tiandahuang/imu-harvester/imu-harvester-back.png

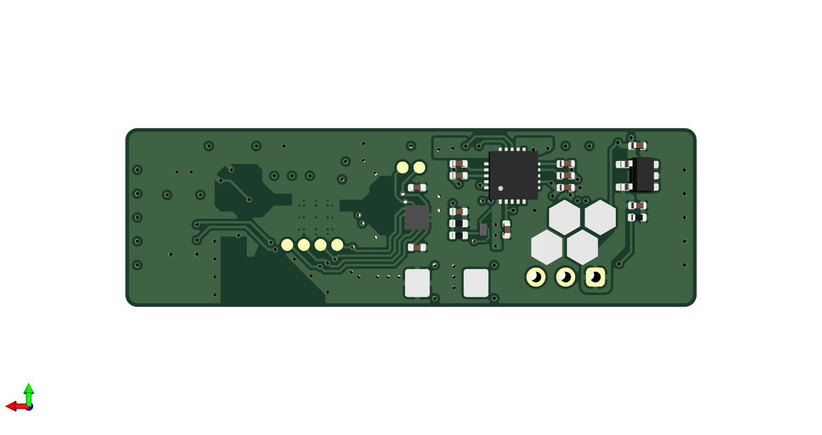
imu-harvester-back.png
