tiandahuang/imu-harvester/imu-harvester-front.png

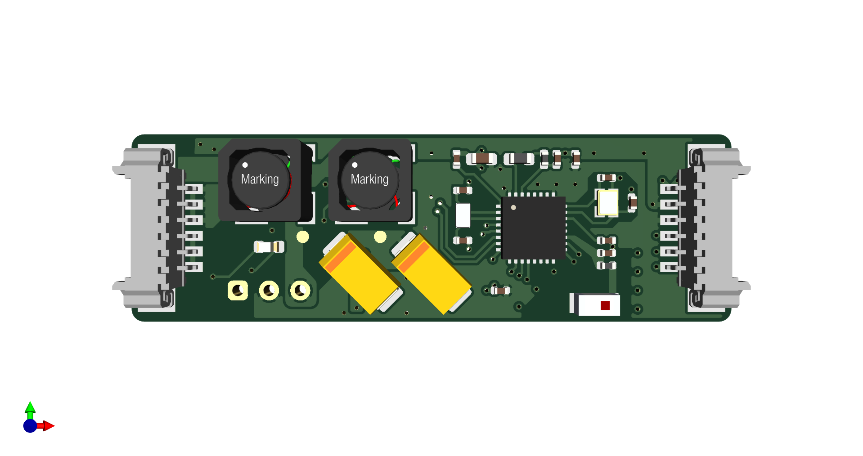
imu-harvester-front.png
