tiandahuang/imu-harvester/imu-harvester.kicad_pcb

## KiCad design imu-harvester.kicad_pcb (2024-02-24)

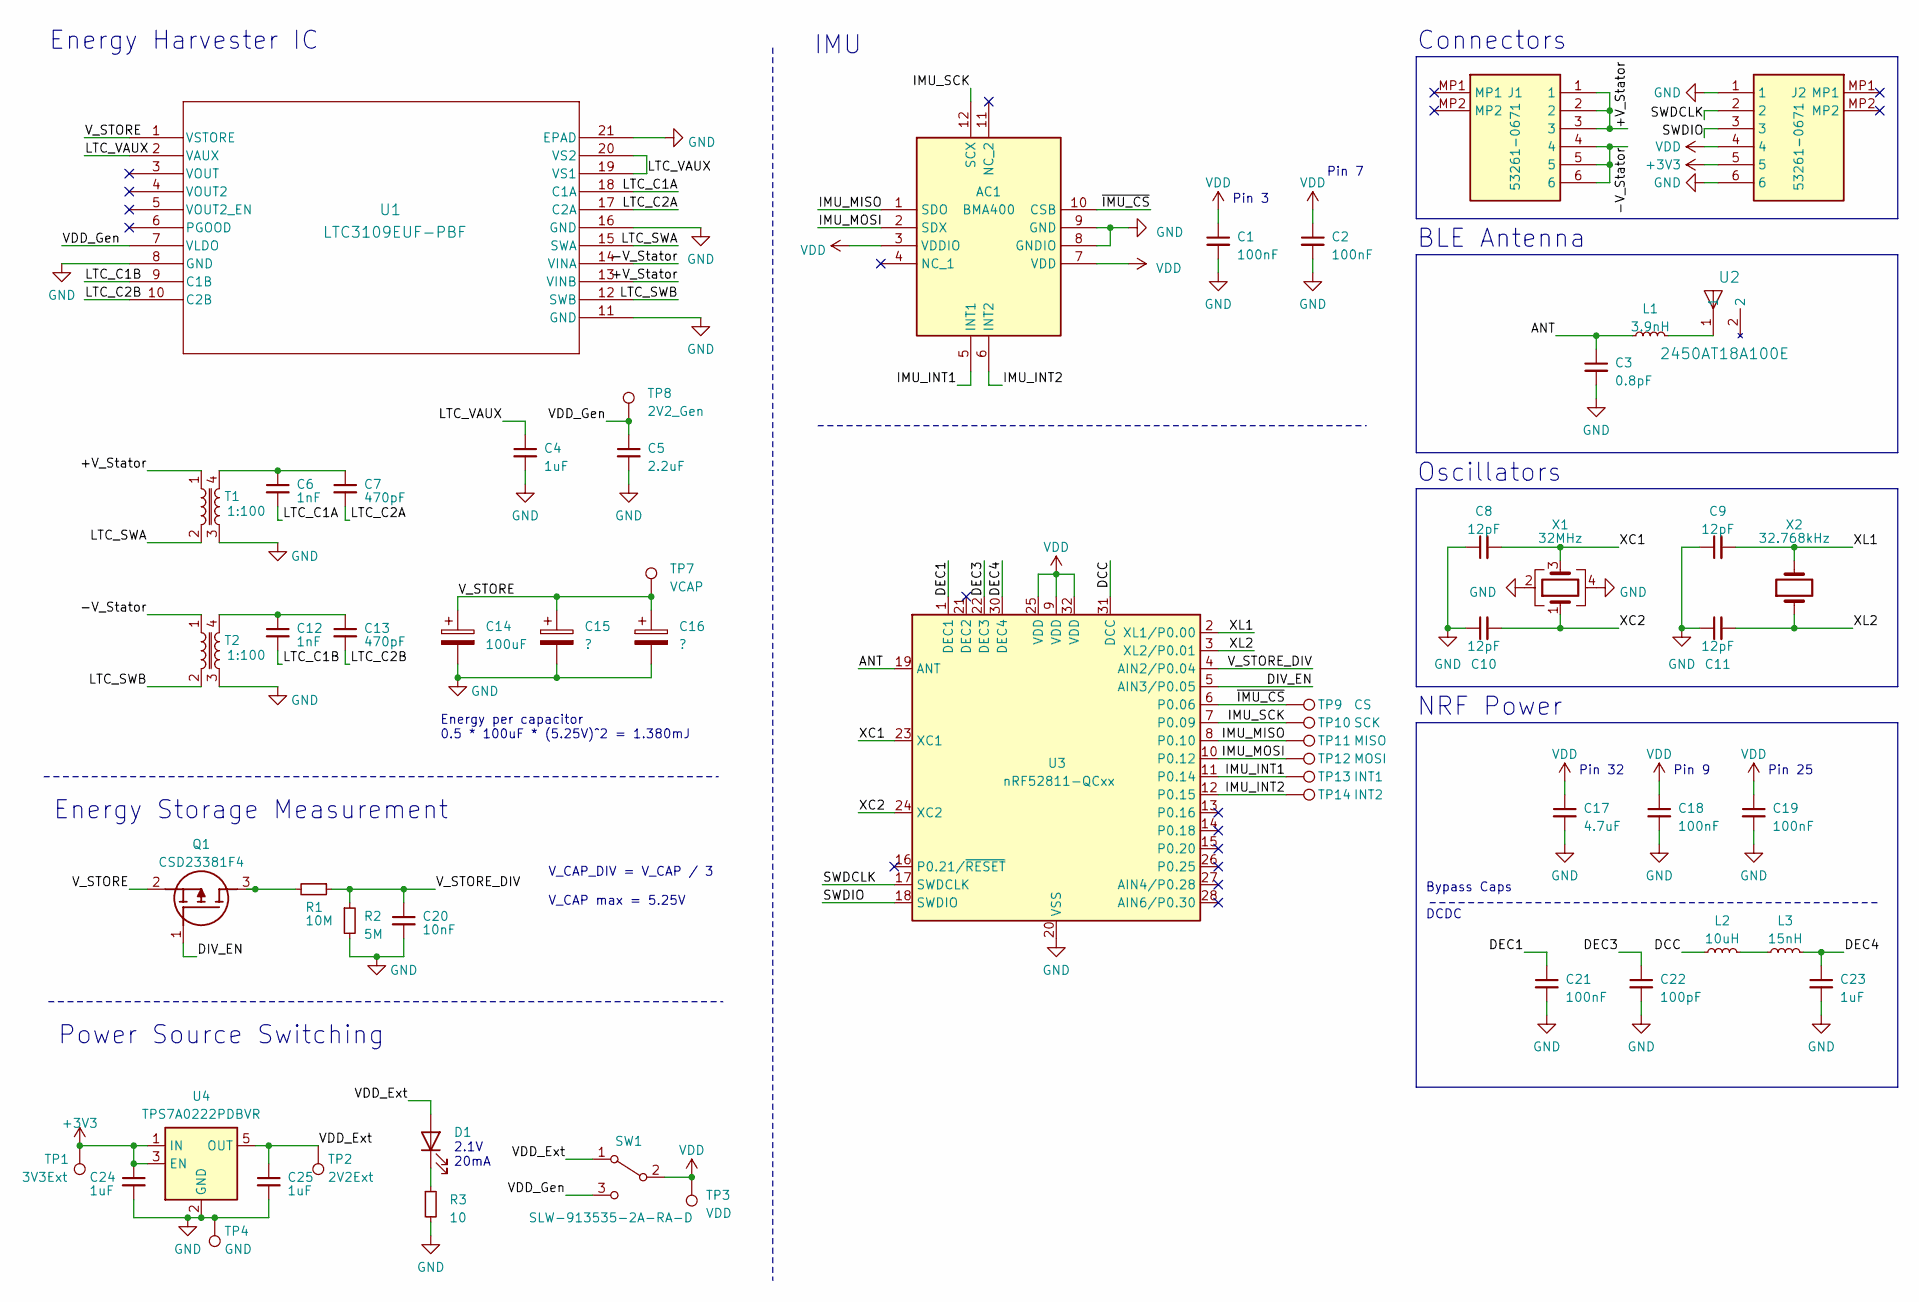
[picture p3: schematic imu-harvester.kicad_sch]

Parts:
AC1: BMA400; BOSCH_LGA-12; Mouser Part Number 262-BMA400
C1, C2, C18, C19, C21: 100nF; C_0402_1005Metric; Manufacturer_Part_Number KGM05AR71C104KN
C3: 0.8pF; C_0402_1005Metric; Manufacturer_Part_Number GRM1555C1ER80BA01D
C4, C23, C24, C25: 1uF; C_0402_1005Metric; Manufacturer_Part_Number CM05X7R105K06AH-HE
C5: 2.2uF; C_0402_1005Metric; Manufacturer_Part_Number GRM155Z71A225KE01D
C6, C12: 1nF; C_0402_1005Metric; Manufacturer_Part_Number C0402C102KCRACAUTO
C7, C13: 470pF; C_0402_1005Metric; Manufacturer_Part_Number KGM05ACG1H471JH
C8, C9, C10, C11: 12pF; C_0402_1005Metric; Manufacturer_Part_Number KGM05ACG1H120JN
C14: 100uF; CP_EIA-6032-28_Kemet-C; Manufacturer_Part_Number TL3C107K010C0200
C15, C16: ?; CP_EIA-6032-28_Kemet-C
C17: 4.7uF; C_0603_1608Metric; Manufacturer_Part_Number GRM188Z71C475KE21D
C20: 10nF; C_0402_1005Metric; Manufacturer_Part_Number C0402C103K1RACAUTO
C22: 100pF; C_0402_1005Metric; Manufacturer_Part_Number KGM05ACG1H101JN
D1: LO Q976.01-P2R2-25-1; LED_0603_1608Metric; Manufacturer_Part_Number LO Q976.01-P2R2-25-1
J1, J2: 53261-0671; 532610671; Mouser Part Number 538-53261-0671
L1: 3.9nH; L_0402_1005Metric; Manufacturer_Part_Number LQG15WZ3N9B02D
L2: 10uH; L_0603_1608Metric; Manufacturer_Part_Number KLZ1608MHR100WTD25
L3: 15nH; L_0402_1005Metric; Manufacturer_Part_Number LQG15WZ15NG02D
Q1: CSD23381F4; Mouser Part Number 595-CSD23381F4
R1: 10M; R_0402_1005Metric; Manufacturer_Part_Number RCC040210M0FKED
R2: 5M; R_0402_1005Metric; Manufacturer_Part_Number CRCW04024M99FKED
R3: 10; R_0402_1005Metric; Manufacturer_Part_Number RCC040210R0FKED
SW1: SLW-913535-2A-RA-D; Manufacturer_Part_Number SLW-913535-2A-RA-D
T1, T2: 1:100; 74488540070; Manufacturer_Part_Number 74488540070
TP1: 3V3Ext; Testpoint_Hex_D3.0
TP2: 2V2Ext; Testpoint_Hex_D3.0
TP3: VDD; Testpoint_Hex_D3.0
TP4: GND; Testpoint_Hex_D3.0
TP7: VCAP; TestPoint_Pad_D1.0mm
TP8: 2V2_Gen; TestPoint_Pad_D1.0mm
TP9: CS; TestPoint_Pad_D1.0mm
TP10: SCK; TestPoint_Pad_D1.0mm
TP11: MISO; TestPoint_Pad_D1.0mm
TP12: MOSI; TestPoint_Pad_D1.0mm
TP13: INT1; TestPoint_Pad_D1.0mm
TP14: INT2; TestPoint_Pad_D1.0mm
U1: LTC3109EUF-PBF; QFN-20_UF_LIT; Manufacturer_Part_Number LTC3109EUF#PBF
U2: 2450AT18A100E; 2450AT18A100E_JOT; Manufacturer_Part_Number 2450AT18A100E
U3: nRF52811-QCxx; QFN-32-1EP_5x5mm_P0.5mm_EP3.6x3.6mm_ThermalVias; Manufacturer_Part_Number nRF52811-QCAA-R
U4: TPS7A0222PDBVR; SOT-23-5; Manufacturer_Part_Number TPS7A0222PDBVR
X1: 32MHz; Crystal_SMD_2016-4Pin_2.0x1.6mm; Manufacturer_Part_Number ECS-320-8-37B2-JTY-TR
X2: 32.768kHz; Crystal_SMD_2012-2Pin_2.0x1.2mm; Manufacturer_Part_Number ECS-.327-9-12R-TR

Connections:
+3V3: C24.1, J2.5, TP1.1, U4.1 (IN), U4.3 (EN)
/+V_Stator: J1.1, J1.2, J1.3, T1.1, U1.13 (VINB)
/-V_Stator: J1.4, J1.5, J1.6, T2.1, U1.14 (VINA)
/ANT: C3.1, L1.1, U3.19 (ANT)
/DCC: L2.1, U3.31 (DCC)
/DEC1: C21.1, U3.1 (DEC1)
/DEC3: C22.1, U3.22 (DEC3)
/DEC4: C23.1, L3.2, U3.30 (DEC4)
/DIV_EN: Q1.1 (G), U3.5 (AIN3/P0.05)
/IMU_INT1: AC1.5 (INT1), TP13.1, U3.11 (P0.14)
/IMU_INT2: AC1.6 (INT2), TP14.1, U3.12 (P0.15)
/IMU_MISO: AC1.1 (SDO), TP11.1, U3.8 (P0.10)
/IMU_MOSI: AC1.2 (SDX), TP12.1, U3.10 (P0.12)
/IMU_SCK: AC1.12 (SCX), TP10.1, U3.7 (P0.09)
/LTC_C1A: C6.2, U1.18 (C1A)
/LTC_C1B: C12.2, U1.9 (C1B)
/LTC_C2A: C7.2, U1.17 (C2A)
/LTC_C2B: C13.2, U1.10 (C2B)
/LTC_SWA: T1.2, U1.15 (SWA)
/LTC_SWB: T2.2, U1.12 (SWB)
/LTC_VAUX: C4.1, U1.2 (VAUX), U1.19 (VS1), U1.20 (VS2)
/SWDCLK: J2.2, U3.17 (SWDCLK)
/SWDIO: J2.3, U3.18 (SWDIO)
/VDD_Ext: C25.1, D1.2 (A), SW1.1 (A), TP2.1, U4.5 (OUT)
/VDD_Gen: C5.1, SW1.3 (C), TP8.1, U1.7 (VLDO)
/V_STORE: C14.1, C15.1, C16.1, Q1.2 (S), TP7.1, U1.1 (VSTORE)
/V_STORE_DIV: C20.1, R1.1, R2.1, U3.4 (AIN2/P0.04)
/XC1: C8.2, U3.23 (XC1), X1.3
/XC2: C10.2, U3.24 (XC2), X1.1
/XL1: C9.2, U3.2 (XL1/P0.00), X2.2
/XL2: C11.2, U3.3 (XL2/P0.01), X2.1
/~IMU_CS: AC1.10 (CSB), TP9.1, U3.6 (P0.06)
GND: AC1.8 (GNDIO), AC1.9 (GND), C1.2, C2.2, C3.2, C4.2, C5.2, C8.1, C9.1, C10.1, C11.1, C14.2, C15.2, C16.2, C17.2, C18.2, C19.2, C20.2, C21.2, C22.2, C23.2, C24.2, C25.2, J2.1, J2.6, R2.2, R3.2, T1.3, T2.3, TP4.1, U1.8 (GND), U1.11 (GND), U1.16 (GND), U1.21 (EPAD), U3.20 (VSS), U3.29 (VSS), U3.33 (VSS), U4.2 (GND), X1.2, X1.4
unnamed: C6.1, C7.1, T1.4
unnamed: C12.1, C13.1, T2.4
unnamed: D1.1 (K), R3.1
unnamed: L1.2, U2.1
unnamed: L2.2, L3.1
unnamed: Q1.3 (D), R1.2
VDD: AC1.3 (VDDIO), AC1.7 (VDD), C1.1, C2.1, C17.1, C18.1, C19.1, J2.4, SW1.2 (B), TP3.1, U3.9 (VDD), U3.25 (VDD), U3.32 (VDD)

Notes on the sheet:
V_CAP_DIV = V_CAP / 3 V_CAP max = 5.25V
Energy Storage Measurement
Pin 3
Power Source Switching
Pin 9
NRF Power
Connectors
DCDC
IMU
2.1V 20mA
Bypass Caps
BLE Antenna
Oscillators
Energy per capacitor 0.5 * 100uF * (5.25V)^2 = 1.380mJ
Pin 32
Pin 25
Energy Harvester IC
Pin 7

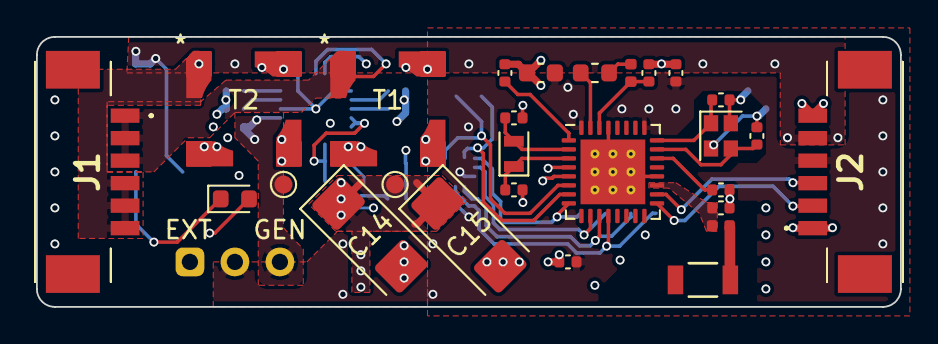
[picture p4: board imu-harvester.kicad_pcb from above]

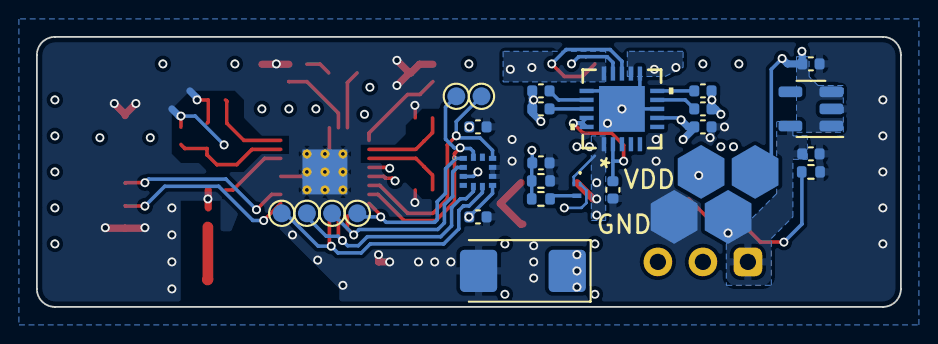
[picture p5: board imu-harvester.kicad_pcb from below]

Board: 4 copper layers, 48.0 x 15.0 mm, 57 parts (29 on the bottom side), 40 nets.
