tiandahuang/imu-harvester/(commit log)

2024-01-19 schematic done
    [imu-harvester.kicad_sch]
2024-01-19 big cap and transformer
    [imu-harvester.kicad_sch]
2024-01-23 bom & gerbers
    [imu-harvester-B_Cu.gbl, imu-harvester-B_Mask.gbs, imu-harvester-B_Paste.gbp, imu-harvester-B_Silkscreen.gbo, imu-harvester-Edge_Cuts.gm1, imu-harvester-F_Cu.gtl, imu-harvester-F_Mask.gts, imu-harvester-F_Paste.gtp]
2024-02-09 gerbers 2
    [imu-harvester-B_Cu.gbl, imu-harvester-B_Mask.gbs, imu-harvester-B_Paste.gbp, imu-harvester-B_Silkscreen.gbo, imu-harvester-Edge_Cuts.gm1, imu-harvester-F_Cu.gtl, imu-harvester-F_Mask.gts, imu-harvester-F_Paste.gtp]
2024-02-23 3d models
    [imu-harvester.kicad_pcb]
